huming2207/simple-p4/README.md

# Simple ESP32-P4 development board

## Status

~~As of 15 Sep 2025, I've just sent it out to JLCPCB for SMT, hasn't confirmed working yet.~~

Loadded via JLC SMT, confirmed working.

Do not use it for production.
