huming2207/simple-p4/simple-p4.pdf

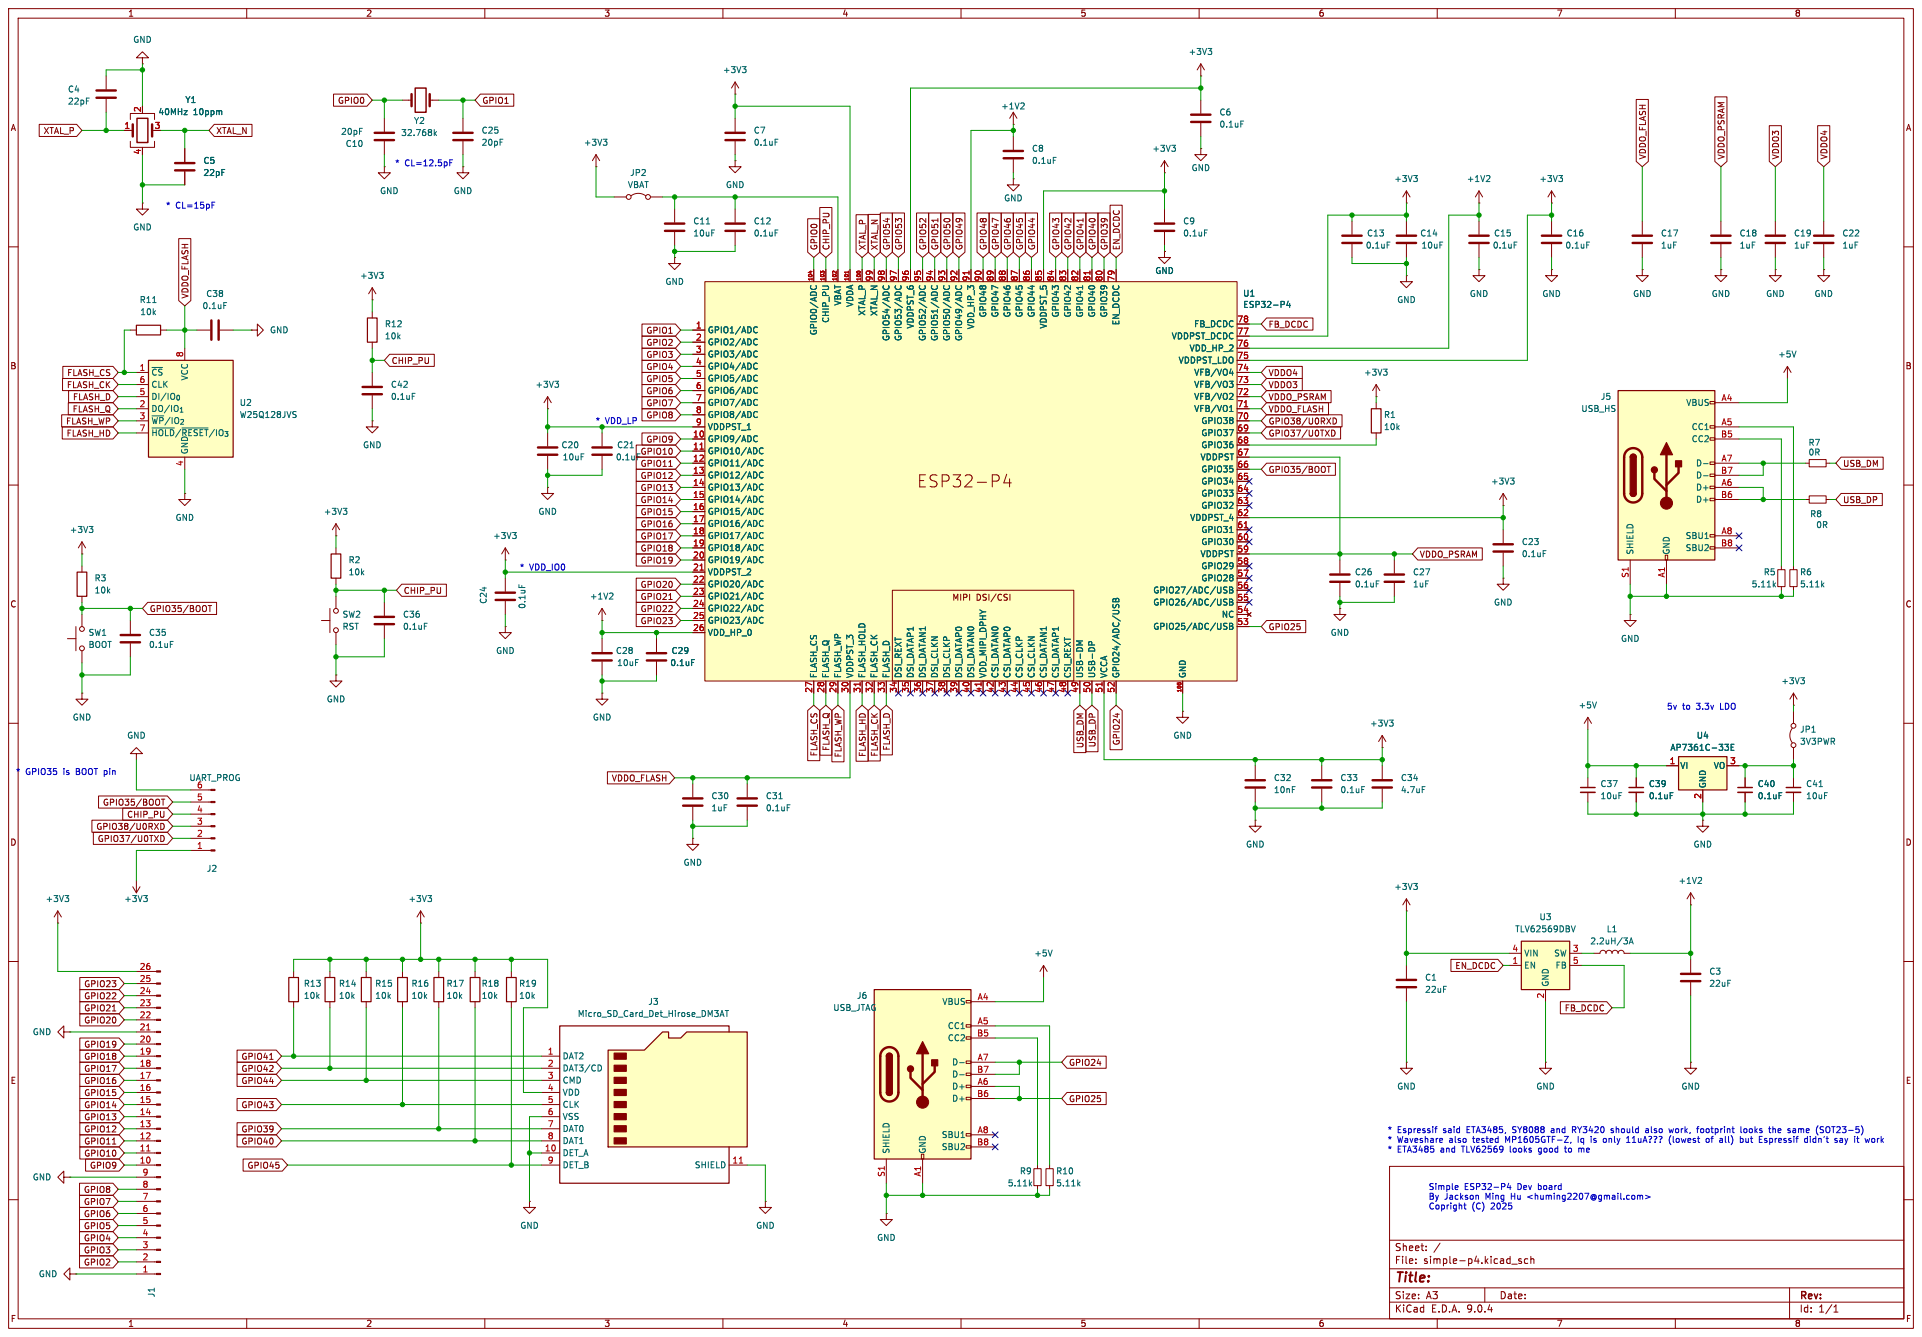
[picture p1: page 1]

Id: 1/1 Title: File: simple-p4.kicad_sch Sheet: /
