huming2207/simple-p4/simple-p4.kicad_pcb

## KiCad design simple-p4.kicad_pcb (2025-09-14)

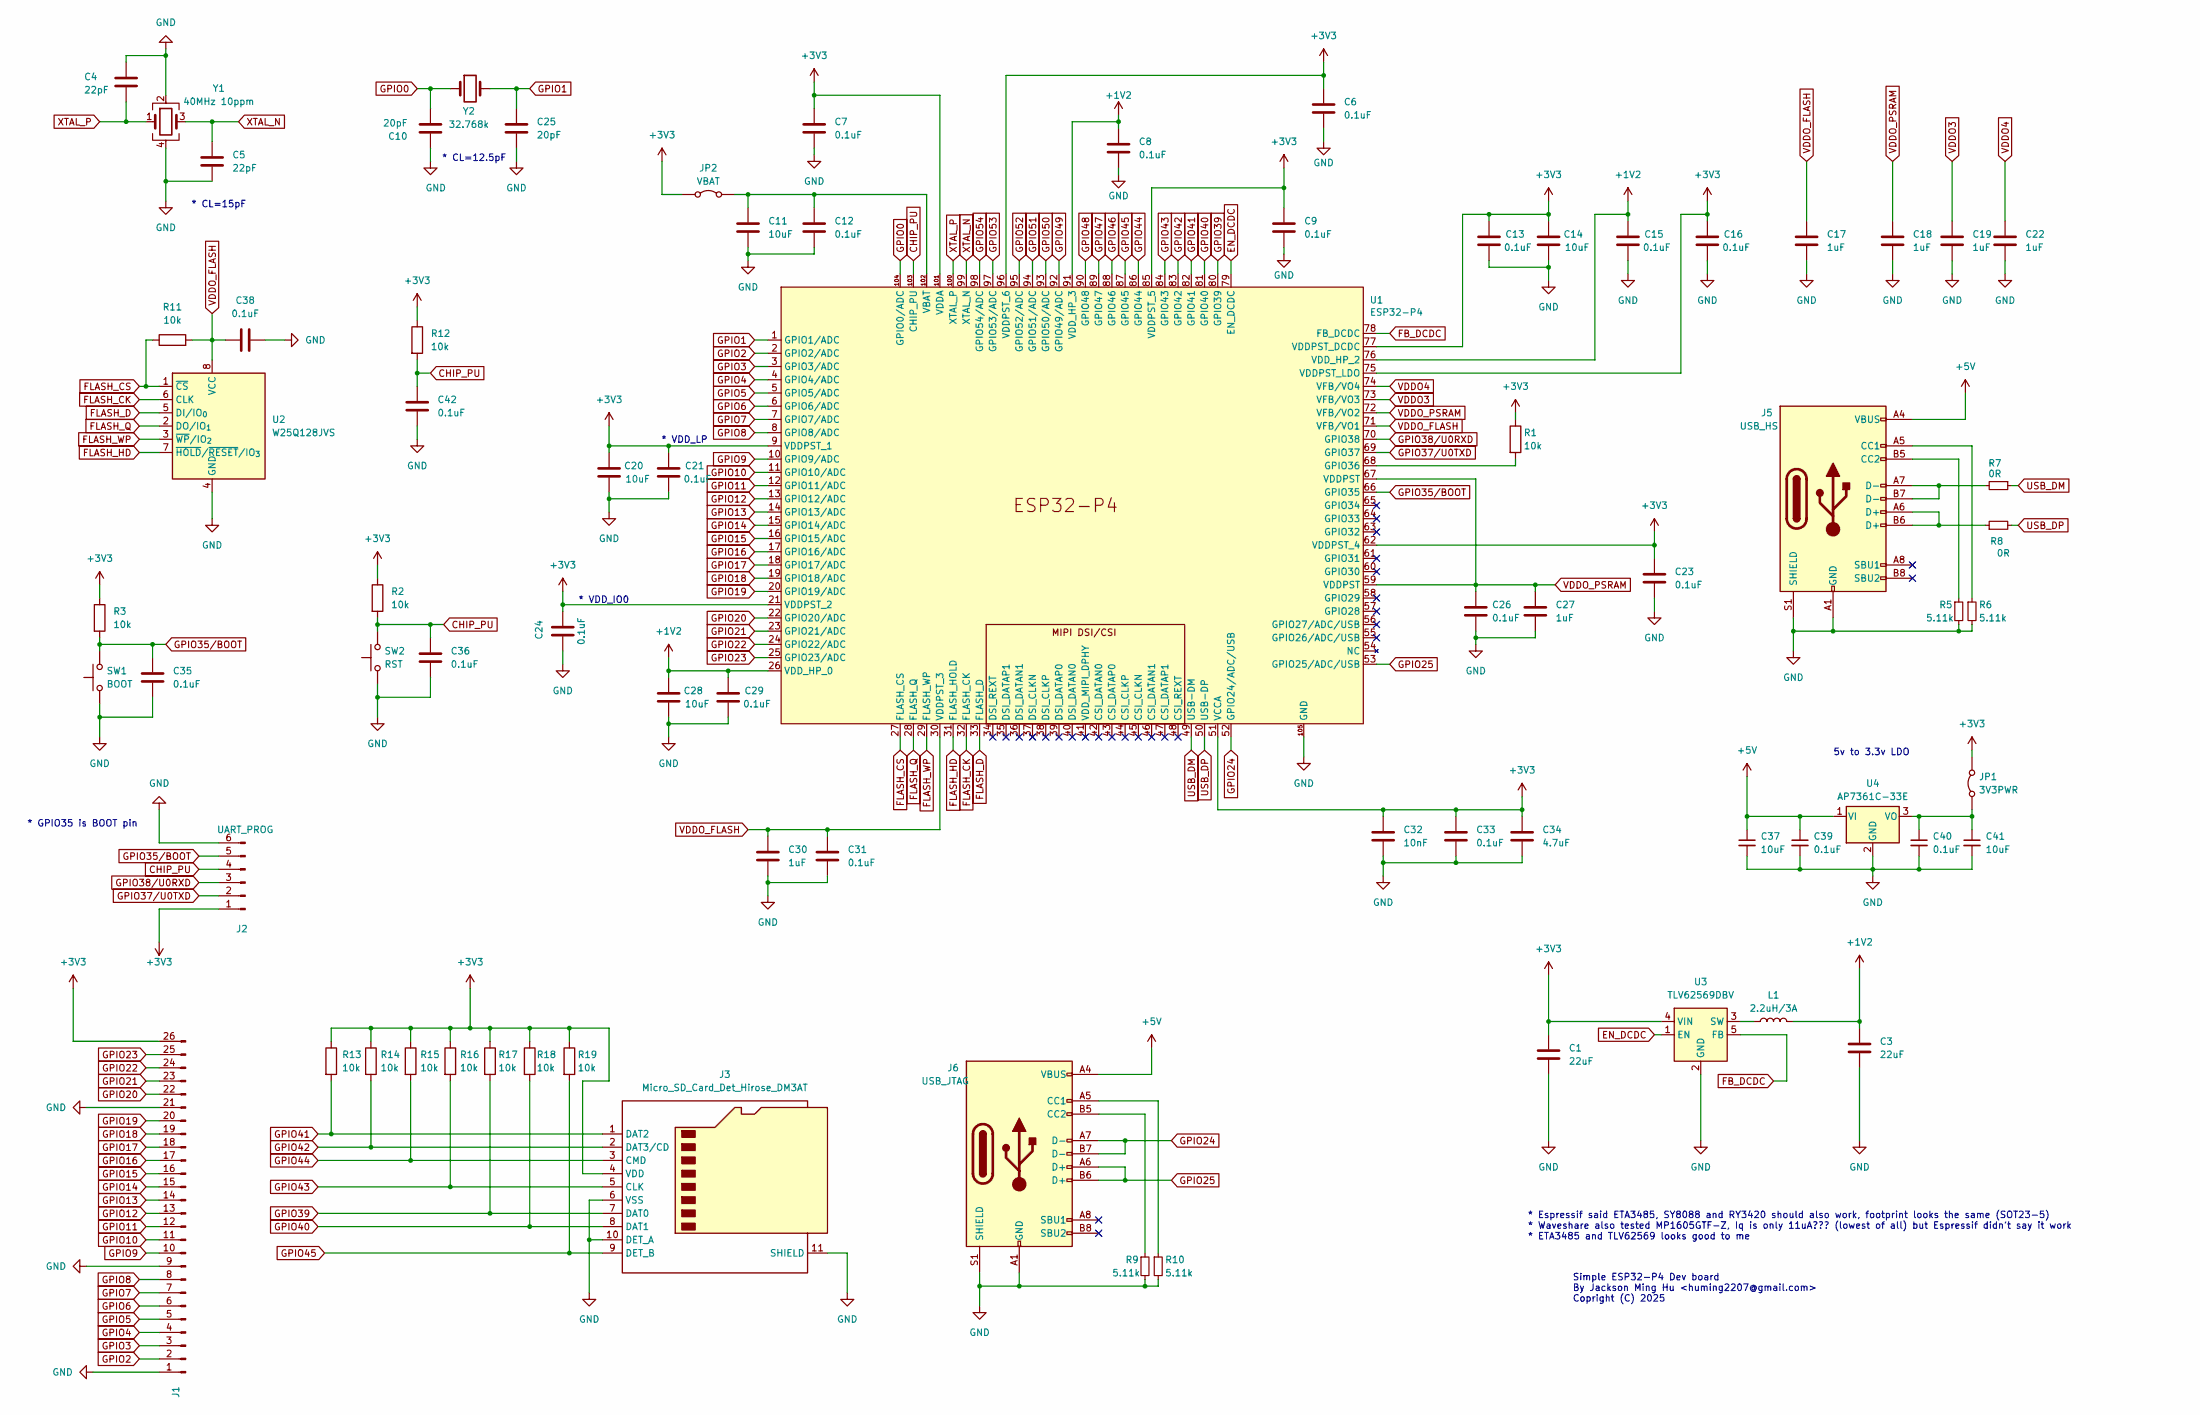
[picture p2: schematic simple-p4.kicad_sch]

Parts:
C1, C3: 22uF; C_0603_1608Metric
C4, C5: 22pF; C_0402_1005Metric
C6, C7, C8, C9, C12, C13, C15, C16, C21, C23, C24, C26, C29, C31, C33, C35, C36, C38, C39, C40, C42: 0.1uF; C_0402_1005Metric
C10, C25: 20pF; C_0402_1005Metric
C11, C14, C20, C28, C37, C41: 10uF; C_0603_1608Metric
C17, C18, C19, C22, C27, C30: 1uF; C_0603_1608Metric
C32: 10nF; C_0402_1005Metric
C34: 4.7uF; C_0603_1608Metric
J1: Conn_01x26_Pin; PinHeader_2x13_P2.54mm_Vertical
J2: UART_PROG; PinHeader_1x06_P2.54mm_Vertical
J3: Micro_SD_Card_Det_Hirose_DM3AT; microSD_HC_Hirose_DM3AT-SF-PEJM5
J5: USB_HS; USB_C_Receptacle_HRO_TYPE-C-31-M-12
J6: USB_JTAG; USB_C_Receptacle_HRO_TYPE-C-31-M-12
JP1: 3V3PWR; SolderJumper-2_P1.3mm_Bridged_Pad1.0x1.5mm
JP2: VBAT; SolderJumper-2_P1.3mm_Bridged_Pad1.0x1.5mm
L1: 2.2uH/3A; L_Changjiang_FTC322510S
R1, R2, R3, R11, R12, R13, R14, R15, R16, R17, R18, R19: 10k; R_0402_1005Metric
R5, R6, R9, R10: 5.11k; R_0402_1005Metric
R7, R8: 0R; R_0402_1005Metric
SW1: BOOT; SW_Push_1P1T_XKB_TS-1187A
SW2: RST; SW_Push_1P1T_XKB_TS-1187A
U1: ESP32-P4
U2: W25Q128JVS; SOIC-8_5.3x5.3mm_P1.27mm
U3: TLV62569DBV; SOT-23-5
U4: AP7361C-33E; SOT-223-3_TabPin2
Y1: 40MHz 10ppm; Crystal_SMD_2016-4Pin_2.0x1.6mm
Y2: 32.768k; Crystal_SMD_3215-2Pin_3.2x1.5mm

Connections:
+1V2: C3.1, C8.1, C15.1, C28.1, C29.1, L1.2, U1.26 (VDD_HP_0), U1.76 (VDD_HP_2), U1.91 (VDD_HP_3)
+3V3: C1.1, C6.1, C7.1, C9.1, C13.1, C14.1, C16.1, C20.1, C21.1, C23.1, C24.2, C32.1, C33.1, C34.1, J1.26, J2.1, J3.4 (VDD), JP1.2 (B), JP2.1 (A), R1.1, R2.1, R3.1, R12.1, R13.1, R14.1, R15.1, R16.1, R17.1, R18.1, R19.1, U1.9 (VDDPST_1), U1.21 (VDDPST_2), U1.51 (VCCA), U1.62 (VDDPST_4), U1.75 (VDDPST_LDO), U1.77 (VDDPST_DCDC), U1.85 (VDDPST_5), U1.96 (VDDPST_6), U1.101 (VDDA), U3.4 (VIN)
+5V: C37.1, C39.1, J5.A4 (VBUS), J5.A9 (VBUS), J5.B4 (VBUS), J5.B9 (VBUS), J6.A4 (VBUS), J6.A9 (VBUS), J6.B4 (VBUS), J6.B9 (VBUS), U4.1 (VI)
CHIP_PU: C36.1, C42.1, J2.4, R2.2, R12.2, SW2.2, U1.103 (CHIP_PU)
EN_DCDC: U1.79 (EN_DCDC), U3.1 (EN)
FB_DCDC: U1.78 (FB_DCDC), U3.5 (FB)
FLASH_CK: U1.32 (FLASH_CK), U2.6 (CLK)
FLASH_CS: R11.1, U1.27 (FLASH_CS), U2.1 (~CS)
FLASH_D: U1.33 (FLASH_D), U2.5 (DI/IO_{0})
FLASH_HD: U1.31 (FLASH_HOLD), U2.7 (~HOLD/~RESET/IO_{3})
FLASH_Q: U1.28 (FLASH_Q), U2.2 (DO/IO_{1})
FLASH_WP: U1.29 (FLASH_WP), U2.3 (~WP/IO_{2})
GND: C1.2, C3.2, C4.1, C5.2, C6.2, C7.2, C8.2, C9.2, C10.1, C11.2, C12.2, C13.2, C14.2, C15.2, C16.2, C17.2, C18.2, C19.2, C20.2, C21.2, C22.2, C23.2, C24.1, C25.2, C26.2, C27.2, C28.2, C29.2, C30.2, C31.2, C32.2, C33.2, C34.2, C35.2, C36.2, C37.2, C38.2, C39.2, C40.2, C41.2, C42.2, J1.1, J1.9, J1.21, J2.6, J3.6 (VSS), J3.10 (DET_A), J3.11 (SHIELD), J5.A1 (GND), J5.A12 (GND), J5.B1 (GND), J5.B12 (GND), J5.S1 (SHIELD), J6.A1 (GND), J6.A12 (GND), J6.B1 (GND), J6.B12 (GND), J6.S1 (SHIELD), R5.2, R6.2, R9.2, R10.2, SW1.1, SW2.1, U1.105 (GND), U2.4 (GND), U3.2 (GND), U4.2 (GND), Y1.2, Y1.4
GPIO0: C10.2, U1.104 (GPIO0/ADC), Y2.1
GPIO1: C25.1, U1.1 (GPIO1/ADC), Y2.2
GPIO2: J1.2, U1.2 (GPIO2/ADC)
GPIO3: J1.3, U1.3 (GPIO3/ADC)
GPIO4: J1.4, U1.4 (GPIO4/ADC)
GPIO5: J1.5, U1.5 (GPIO5/ADC)
GPIO6: J1.6, U1.6 (GPIO6/ADC)
GPIO7: J1.7, U1.7 (GPIO7/ADC)
GPIO8: J1.8, U1.8 (GPIO8/ADC)
GPIO9: J1.10, U1.10 (GPIO9/ADC)
GPIO10: J1.11, U1.11 (GPIO10/ADC)
GPIO11: J1.12, U1.12 (GPIO11/ADC)
GPIO12: J1.13, U1.13 (GPIO12/ADC)
GPIO13: J1.14, U1.14 (GPIO13/ADC)
GPIO14: J1.15, U1.15 (GPIO14/ADC)
GPIO15: J1.16, U1.16 (GPIO15/ADC)
GPIO16: J1.17, U1.17 (GPIO16/ADC)
GPIO17: J1.18, U1.18 (GPIO17/ADC)
GPIO18: J1.19, U1.19 (GPIO18/ADC)
GPIO19: J1.20, U1.20 (GPIO19/ADC)
GPIO20: J1.22, U1.22 (GPIO20/ADC)
GPIO21: J1.23, U1.23 (GPIO21/ADC)
GPIO22: J1.24, U1.24 (GPIO22/ADC)
GPIO23: J1.25, U1.25 (GPIO23/ADC)
GPIO24: J6.A7 (D-), J6.B7 (D-), U1.52 (GPIO24/ADC/USB)
GPIO25: J6.A6 (D+), J6.B6 (D+), U1.53 (GPIO25/ADC/USB)
GPIO35/BOOT: C35.1, J2.5, R3.2, SW1.2, U1.66 (GPIO35)
GPIO37/U0TXD: J2.2, U1.69 (GPIO37)
GPIO38/U0RXD: J2.3, U1.70 (GPIO38)
GPIO39: J3.7 (DAT0), R17.2, U1.80 (GPIO39)
GPIO40: J3.8 (DAT1), R18.2, U1.81 (GPIO40)
GPIO41: J3.1 (DAT2), R13.2, U1.82 (GPIO41)
GPIO42: J3.2 (DAT3/CD), R14.2, U1.83 (GPIO42)
GPIO43: J3.5 (CLK), R16.2, U1.84 (GPIO43)
GPIO44: J3.3 (CMD), R15.2, U1.86 (GPIO44)
GPIO45: J3.9 (DET_B), R19.2, U1.87 (GPIO45)
GPIO46: U1.88 (GPIO46)
GPIO47: U1.89 (GPIO47)
GPIO48: U1.90 (GPIO48)
GPIO49: U1.92 (GPIO49/ADC)
GPIO50: U1.93 (GPIO50/ADC)
GPIO51: U1.94 (GPIO51/ADC)
GPIO52: U1.95 (GPIO52/ADC)
GPIO53: U1.97 (GPIO53/ADC)
GPIO54: U1.98 (GPIO54/ADC)
unnamed: J5.A5 (CC1), R6.1
unnamed: J5.B5 (CC2), R5.1
unnamed: J5.A6 (D+), J5.B6 (D+), R8.1
unnamed: J5.A7 (D-), J5.B7 (D-), R7.2
unnamed: J6.A5 (CC1), R10.1
unnamed: J6.B5 (CC2), R9.1
unnamed: C40.1, C41.1, JP1.1 (A), U4.3 (VO)
unnamed: C11.1, C12.1, JP2.2 (B), U1.102 (VBAT)
unnamed: R1.2, U1.68 (GPIO36)
unnamed: L1.1, U3.3 (SW)
USB_DM: R7.1, U1.49 (USB-DM)
USB_DP: R8.2, U1.50 (USB-DP)
VDDO3: C19.1, U1.73 (VFB/VO3)
VDDO4: C22.1, U1.74 (VFB/VO4)
VDDO_FLASH: C17.1, C30.1, C31.1, C38.1, R11.2, U1.30 (VDDPST_3), U1.71 (VFB/VO1), U2.8 (VCC)
VDDO_PSRAM: C18.1, C26.1, C27.1, U1.59 (VDDPST), U1.67 (VDDPST), U1.72 (VFB/VO2)
XTAL_N: C5.1, U1.99 (XTAL_N), Y1.3
XTAL_P: C4.2, U1.100 (XTAL_P), Y1.1

Notes on the sheet:
* VDD_IO0
* CL=12.5pF
Simple ESP32-P4 Dev board By Jackson Ming Hu <huming2207@gmail.com> Copright (C) 2025
5v to 3.3v LDO
* VDD_LP
* CL=15pF
* GPIO35 is BOOT pin
* Espressif said ETA3485, SY8088 and RY3420 should also work, footprint looks the same (SOT23-5) * Waveshare also tested MP1605GTF-Z, Iq is only 11uA??? (lowest of all) but Espressif didn't say it work * ETA3485 and TLV62569 looks good to me

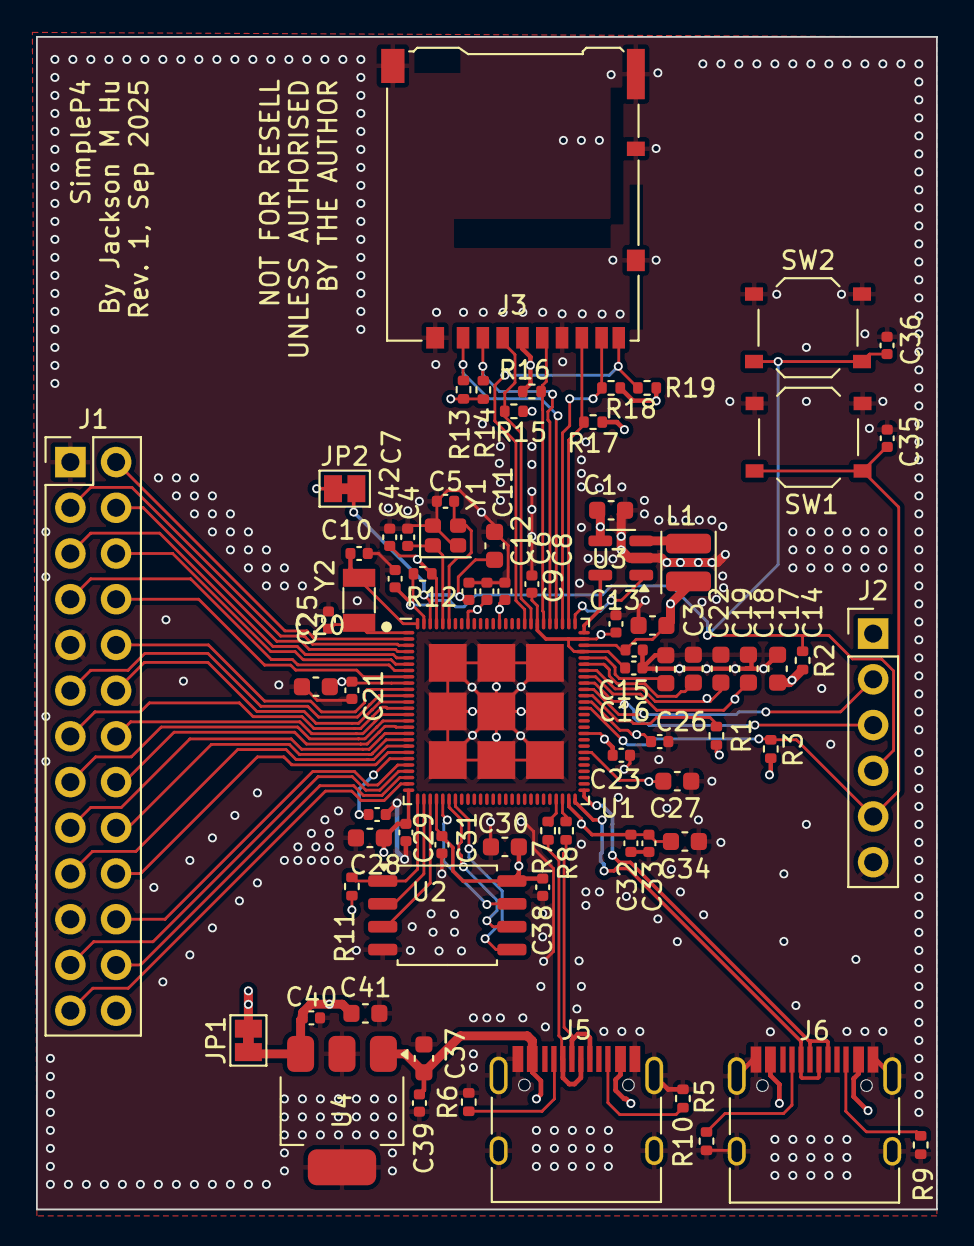
[picture p3: board simple-p4.kicad_pcb from above]

Board: 4 copper layers, 50.0 x 65.1 mm, 75 parts (0 on the bottom side), 67 nets.
