huming2207/simple-p4/(commit log)

2025-09-04 Implement schematic for basic ESP32-P4 nets
    [simple-p4.kicad_sch]
2025-09-06 schematic: add crystal
    [simple-p4.kicad_sch]
2025-09-07 schematic: add USB port
    [simple-p4.kicad_sch]
2025-09-10 Finish PCB
    [simple-p4-CuBottom.gbr, simple-p4-CuTop.gbr, simple-p4-EdgeCuts.gbr, simple-p4-MaskBottom.gbr, simple-p4-MaskTop.gbr, simple-p4-NPTH.drl, simple-p4-PTH.drl, simple-p4-SilkBottom.gbr]
2025-09-11 Finish off PCB
    [simple-p4-CuBottom.gbr, simple-p4-CuIn1.gbr, simple-p4-CuIn2.gbr, simple-p4-CuTop.gbr, simple-p4-EdgeCuts.gbr, simple-p4-MaskBottom.gbr, simple-p4-MaskTop.gbr, simple-p4-NPTH.drl]
2025-09-14 Finish off rev. 1
    [simple-p4-CuBottom.gbr, simple-p4-CuIn1.gbr, simple-p4-CuIn2.gbr, simple-p4-CuTop.gbr, simple-p4-EdgeCuts.gbr, simple-p4-MaskBottom.gbr, simple-p4-MaskTop.gbr, simple-p4-NPTH.drl]
2025-09-22 Update rev1 PDF schematic
